xiaoli79/26-electronic-competition/code/2026-game/模块引脚定义.md

# 2026-extend 模块引脚定义

本文根据 `empty.syscfg`（SysConfig 配置源文件）及 `user_driver` 中的实际驱动代码整理。芯片为 **MSPM0G3507（LQFP-64）**。

> 约定：`PAx` / `PBx` 表示 MCU 的 GPIO 引脚；所有外设模块必须与 MCU **共地（GND）**。引脚复用及宏定义由 SysConfig 生成到 `ti_msp_dl_config.h`。

## 总览

| 模块 | 接口/外设 | MCU 引脚 | 说明 |
| --- | --- | --- | --- |
| 调试串口 | UART0 | PA10 / PA11 | 115200 bps |
| IMU601 | UART3 | PA25 / PA26 | 115200 bps，接收中断 |
| OLED | I2C1 | PB2 / PB3 | 100 kHz，地址 `0x3C` |
| 舵机 | TIMG7 PWM | PA27 | PWM 通道 1 |
| TB6612 电机驱动 | GPIO + TIMG0 PWM | PA7、PA8、PA9、PA12、PA13、PB18、PB24 | 双电机方向、使能与 PWM |
| 电机编码器 | GPIO 输入 | PA21、PA22、PB19、PB20 | 两路 AB 相编码器 |
| 8 路红外 | I2C0 | PA28 / PA31 | 100 kHz，7 位地址 `0x09` |
| 按键 | GPIO | PB6、PB7 | 下拉输入，按下为高电平 |
| LED / 蜂鸣器 | GPIO | PA14、PA15 | 蜂鸣器低电平有效 |
| 旋钮 | ADC1 | PA16 | ADC 通道 1，2.5 V 内部参考 |

## 串口

### 调试串口（DEBUG / UART0）

| 模块端信号 | MCU 引脚 | MCU 信号 | 说明 |
| --- | --- | --- | --- |
| 外部设备 RX | PA10 | UART0_TX | MCU 发出的调试信息接到此处 |
| 外部设备 TX | PA11 | UART0_RX | MCU 接收外部数据 |
| GND | GND | GND | 必须共地 |

- 波特率：`115200`
- 驱动实例：`DEBUG_INST`（UART0）
- 发送函数：`UART_send_char()`、`UART_send_string()`、`UART_send_buffer()`

### IMU601 姿态模块（UART3）

| IMU601 引脚 | MCU 引脚 | MCU 信号 | 说明 |
| --- | --- | --- | --- |
| V | 5V | 电源 | 按现有驱动注释使用 5 V 供电 |
| G | GND | GND | 必须共地 |
| T / TX | PA25 | UART3_RX | **模块发送接 MCU 接收** |
| R / RX | PA26 | UART3_TX | **模块接收接 MCU 发送** |

- 波特率：`115200`
- 驱动实例：`IMU601_INST`（UART3）
- UART RX 中断已启用，驱动会接收 12 字节姿态帧并解析 yaw、pitch、roll。

## 显示与人机交互

### OLED（I2C1）

| OLED 引脚 | MCU 引脚 | MCU 信号 | 说明 |
| --- | --- | --- | --- |
| VCC | 3.3V / 按模块额定电压供电 | 电源 | I2C 电平须与 MCU 3.3 V 兼容 |
| GND | GND | GND | 必须共地 |
| SCL | PB2 | I2C1_SCL | 时钟线，内部上拉已配置 |
| SDA | PB3 | I2C1_SDA | 数据线，内部上拉已配置 |

- I2C 速率：`100 kHz`
- OLED 地址：`0x3C`
- 当前代码没有使用 OLED 的 RST 引脚；适用于无独立 RST 或已硬件复位的模块。

### 按键

| 按键 | MCU 引脚 | 配置 | 程序含义 |
| --- | --- | --- | --- |
| KEY1 | PB6 | 输入、内部下拉、上升沿中断 | 高电平表示按下，用于切换 `task` |
| KEY2 | PB7 | 输入、内部下拉、上升沿中断 | 高电平表示按下，用于启动任务 |

主循环目前通过 `get_key_state()` 轮询按键状态；按键按下时应将引脚拉至 3.3 V。

### LED 与蜂鸣器

| 模块 | MCU 引脚 | 有效电平 | 函数 |
| --- | --- | --- | --- |
| LED | PA14 | 高电平点亮 | `led_on()` / `led_off()` |
| 蜂鸣器 | PA15 | **低电平响** | `beep_on()` / `beep_off()` |

蜂鸣器在 SysConfig 中的初始电平为高，因此上电默认关闭。

### 舵机

| 信号 | MCU 引脚 | 外设 | 说明 |
| --- | --- | --- | --- |
| Servo PWM | PA27 | TIMG7_CCP1 | PWM 通道 1 |

- 定时器时钟：100 kHz；计数周期：2000。
- `main.c` 当前将比较值设为 50；具体脉宽是否匹配舵机，需按实际舵机和 PWM 配置再次确认。

## 电机与编码器

### TB6612 双路电机驱动

| TB6612 信号 | MCU 引脚 | 功能 |
| --- | --- | --- |
| STBY | PB24 | 驱动待机控制；高电平使能 |
| AIN1 | PA9 | 电机 1 方向控制 |
| AIN2 | PA8 | 电机 1 方向控制 |
| PWMA | PA12 | 电机 1 PWM（TIMG0_CCP0） |
| BIN1 | PA7 | 电机 2 方向控制 |
| BIN2 | PB18 | 电机 2 方向控制 |
| PWMB | PA13 | 电机 2 PWM（TIMG0_CCP1） |
| VM | 12 V 电机电源 | MG513X 电机电源；**不能接 MCU 3.3 V 引脚**，负极必须与 MCU 共地 |
| VCC | 3.3V | 逻辑电源 | 与 MCU 逻辑电平一致 |
| GND | GND | 共地 | MCU、TB6612 与电机电源负极需共地 |

> 注意：`motor.h` 中旧注释把 AIN1/AIN2 的文字顺序写成了 PA8/PA9；实际生效的 SysConfig 宏和程序映射为：**PA9 = AIN1，PA8 = AIN2**，接线请以本表为准。

程序中的方向电平定义如下：

| 电机 | 停止（刹车） | `direction = 1` | `direction = 2` |
| --- | --- | --- | --- |
| 电机 1 | AIN1=1，AIN2=1 | AIN1=0，AIN2=1 | AIN1=1，AIN2=0 |
| 电机 2 | BIN1=1，BIN2=1 | BIN1=1，BIN2=0 | BIN1=0，BIN2=1 |

PWM 使用 TIMG0，计数周期为 4000；`motor_set_duty()` 的公共限幅为 `0~2500`，任务 2 正常驱动进一步限制为 `0~1800`，短刹使用 2500。

### 电机编码器

| 编码器 | 信号 | MCU 引脚 | 配置/用途 |
| --- | --- | --- | --- |
| 电机 1 | A 相（AA） | PA21 | 输入、下拉、双边沿中断 |
| 电机 1 | B 相（AB） | PA22 | 输入、下拉、双边沿中断 |
| 电机 2 | A 相（BA） | PB19 | 输入、下拉、双边沿中断 |
| 电机 2 | B 相（BB） | PB20 | 输入、下拉、双边沿中断 |

当前程序使用 AB 正交状态查表，统计 A、B 两相的上升沿和下降沿。合法边沿按方向加减计数，两位同时跳变的非法状态会被忽略。

MG513X P28 的电机轴编码器为 13 线、减速比为 1:28，因此当前计数方式下：

```text
输出轴每圈四倍频计数 = 13 × 28 × 4 = 1456
65 mm 轮胎周长 = π × 65 ≈ 204.2 mm
每计数距离 = 204.2 / 1456 ≈ 0.140 mm
```

首次装车仍需缓慢转动输出轴一整圈验证是否约为 1456 个四倍频计数，防止厂商所称“13 线”的计数口径不同。

## 八路红外循迹模块（板载 MCU + I2C）

模块由板载 MCU 汇总八路红外状态，MSPM0G3507 通过 I2C0 从固定 7 位地址 `0x09` 直接读取一个 8 位状态字节。

| 八路红外模块信号 | MCU 引脚 | MCU 信号 | 说明 |
| --- | --- | --- | --- |
| SDA | PA28 | I2C0_SDA | 数据线，配置内部上拉 |
| SCL | PA31 | I2C0_SCL | 时钟线，配置内部上拉 |
| VCC | 3.3 V 兼容电源 | 电源 | SDA/SCL 上拉电压不得超过 MCU 允许范围 |
| GND | GND | 共地 | 必须共地 |

- I2C 速率：`100 kHz`
- I2C 7 位从机地址：`0x09`
- 默认直接读取一个字节，不先发送寄存器或命令。
- 默认 `bit0` 对应最左路、`bit7` 对应最右路、位值 `1` 表示黑线。
- 若实物位序或黑白极性相反，可修改 `huidu.h` 中的 `EIGHT_ROAD_IR_REVERSE_BITS` 或 `EIGHT_ROAD_IR_ACTIVE_LOW`。
- 上层仍使用 `huidu_value[0..7]`，因此现有任务 2～5 的巡线和横线检测逻辑不需要修改。

原 CD4051 灰度 GPIO 配置和驱动代码已注释保留，PA17、PA24、PB8、PB9 不再由灰度模块占用。

## 模拟输入

### 旋钮（ADC1）

| 模块信号 | MCU 引脚 | ADC 配置 |
| --- | --- | --- |
| 旋钮电压输出 | PA16 | ADC1 通道 1，连续转换，2.5 V 内部参考 |

旋钮两端通常接 3.3 V 与 GND，滑动端接 PA16；请保证 PA16 的输入电压不超过 MCU 允许范围。

## 系统与保留引脚

| 用途 | MCU 引脚 | 说明 |
| --- | --- | --- |
| 外部 40 MHz 晶振 | PA5 | HFXIN |
| 外部 40 MHz 晶振 | PA6 | HFXOUT |
| SWD 调试 | PA19 | SWDIO；下载/调试时保留 |
| SWD 调试 | PA20 | SWCLK；下载/调试时保留 |
| VREF 引脚 | PA23 | SysConfig 为电压基准正端预留 |
| PID 定时器 | 无外部引脚 | TIMA0，10 ms 周期中断 |
| 时间基准 | 无外部引脚 | TIMG12，供 `get_time_stamp_ms()` 使用 |

## 接线前检查

1. 先连接所有模块的 GND，再连接信号线和电源。
2. UART 必须交叉连接：模块 TX → MCU RX，模块 RX → MCU TX。
3. MSPM0G3507 GPIO 为 3.3 V 逻辑；若 5 V 模块的输出为 5 V，需要增加电平转换或分压，不能直接接入 MCU。
4. 电机电源与逻辑电源分开供电时，仍必须共地；不要把电机电源接到 MCU 的 3.3 V 输出。
