xiaoli79/26-electronic-competition/模块相关资料/【云台】02_DCC-100v3说明书-2026-05-24.pdf

# DCC-100v3模块说明书

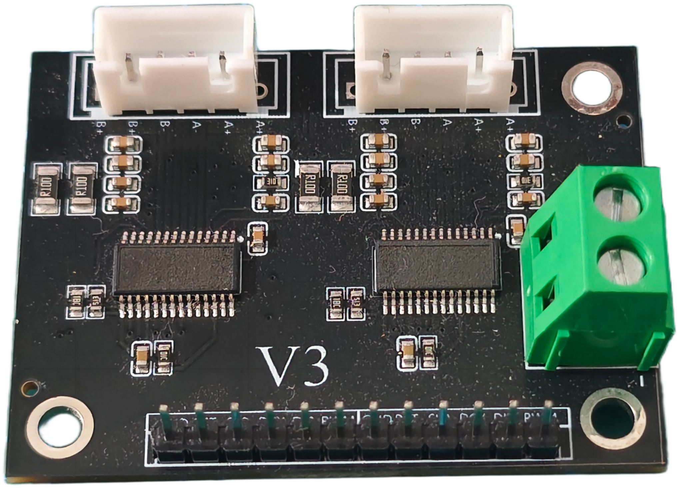
[picture p7: figure]
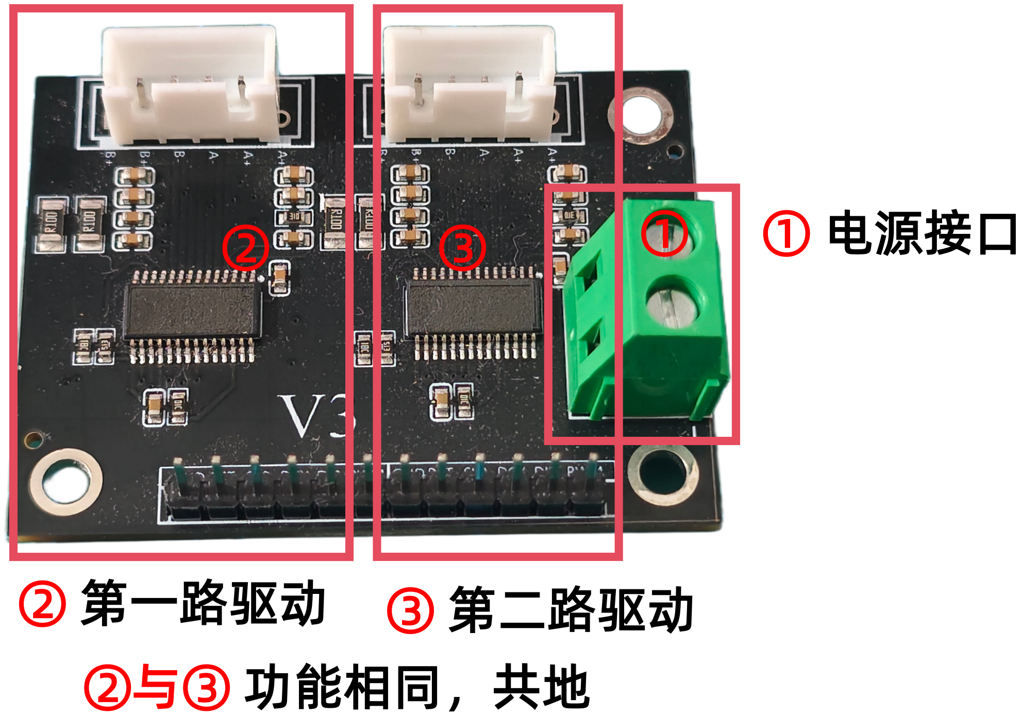
[picture p8: page 2]

② | ③ | ① ① 电源接口

# ② 第一路驱动 ③ 第二路驱动 ②与③ 功能相同，共地

PWM | 接脉冲信号，一个脉冲转一个微步，即0.05625度
DIR | 方向控制：高低电平分别表示不同转向
DCY | 电流衰减：高电平大扭矩；低电平小扭矩；悬空不接则自动确定电流衰减模式
SLP | 休眠：高电平工作，低电平休眠
RST | 复位：高电平工作
GND | 0电压参考点
逻辑电平 | 3.3V高电平，0V低电平
供电方式 | 通过绿色接线端子供电，可接受电压范围为11~26V

# 发货清单

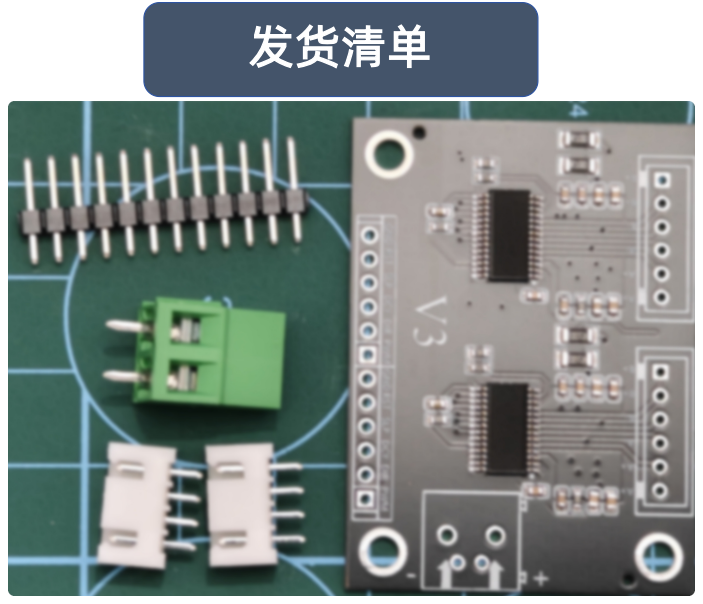
[picture p9: page 4]
