xiaoli79/26-electronic-competition/(list of files, drawings)

Other design files:
PCB板/小车底板.epro
PCB板/按键PCB_2026-08-31.epro
