xiaoli79/26-electronic-competition/code/2026-game/user_driver/uart.h

#ifndef UART_H
#define UART_H

#include "ti_msp_dl_config.h"



void UART_send_string(UART_Regs *uart, const char *str);
void UART_send_char(UART_Regs *uart, const uint8_t chr);
void UART_send_buffer(UART_Regs *uart, const uint8_t *buf, const uint8_t l);

#endif /* UART_H */
