xiaoli79/26-electronic-competition/(commit log)

2026-08-31 2026电赛H题
    [小车底板.epro, 按键PCB_2026-08-31.epro]
2026-08-31 修改md
